dangphan1803/ESP32C3-Google-Map-Navigation-Chronos-Android/docs/images/demo.gif

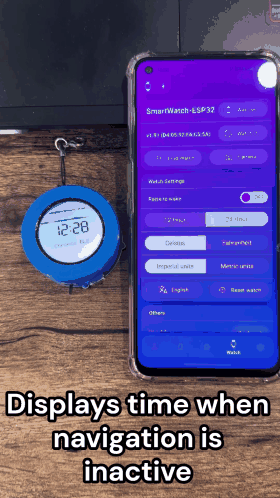
docs/images/demo.gif
