dangphan1803/ESP32C3-Google-Map-Navigation-Chronos-Android/FIle_in_3D/De_VER2.3mf

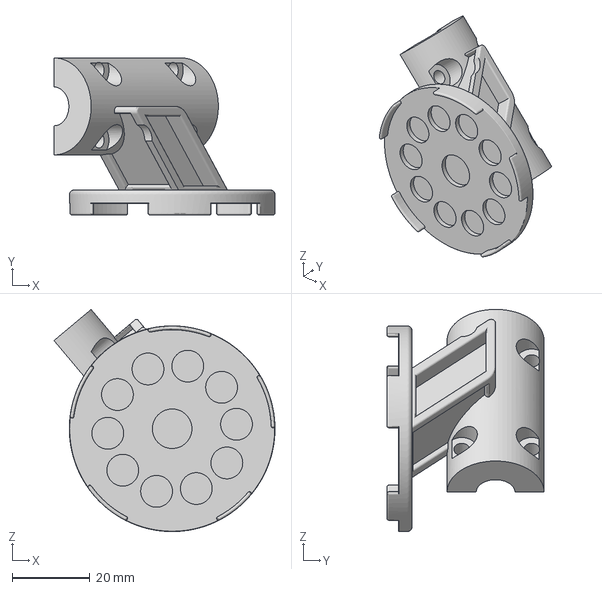
[picture p9: CAD file, 2026-10-22]
FIle_in_3D/De_VER2.3mf
56.9 x 40.5 x 57.2 mm
