dangphan1803/ESP32C3-Google-Map-Navigation-Chronos-Android/FIle_in_3D/Nap_Ver2.3mf

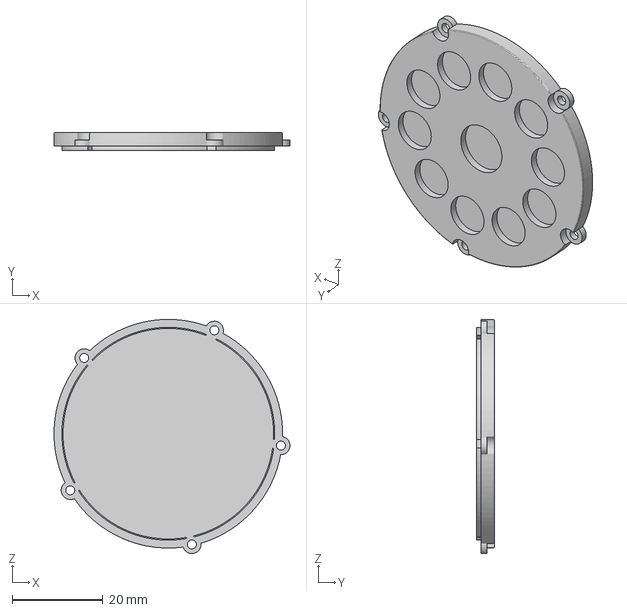
[picture p10: CAD file, 2026-10-22]
FIle_in_3D/Nap_Ver2.3mf
52.1 x 4.00 x 51.7 mm
