dangphan1803/ESP32C3-Google-Map-Navigation-Chronos-Android/FIle_in_3D/Van_Oc.3mf

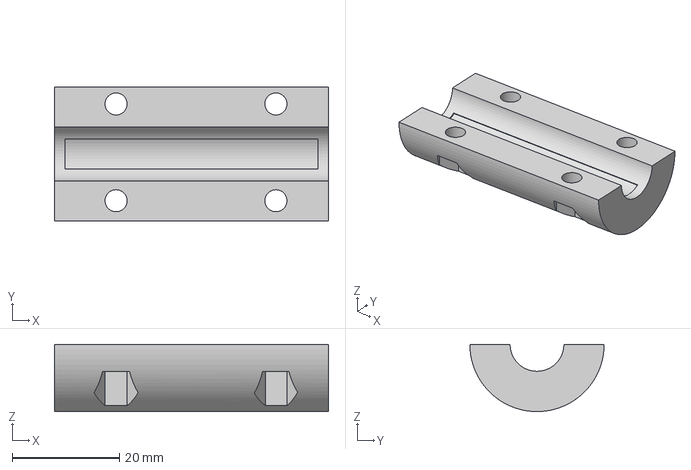
[picture p11: CAD file, 2026-10-22]
FIle_in_3D/Van_Oc.3mf
51.0 x 25.0 x 12.5 mm
