dangphan1803/ESP32C3-Google-Map-Navigation-Chronos-Android/FIle_in_3D/Hop.3mf

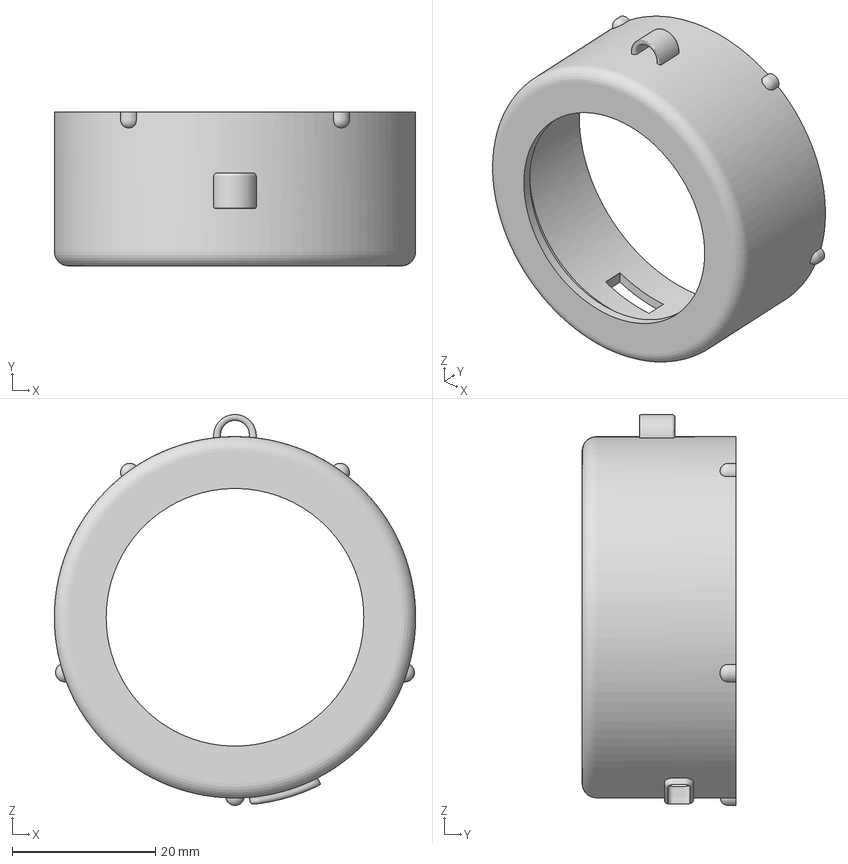
[picture p12: CAD file, 2026-10-22]
FIle_in_3D/Hop.3mf
50.5 x 21.5 x 54.6 mm
