dangphan1803/ESP32C3-Google-Map-Navigation-Chronos-Android/docs/images/CallTest2.jpg

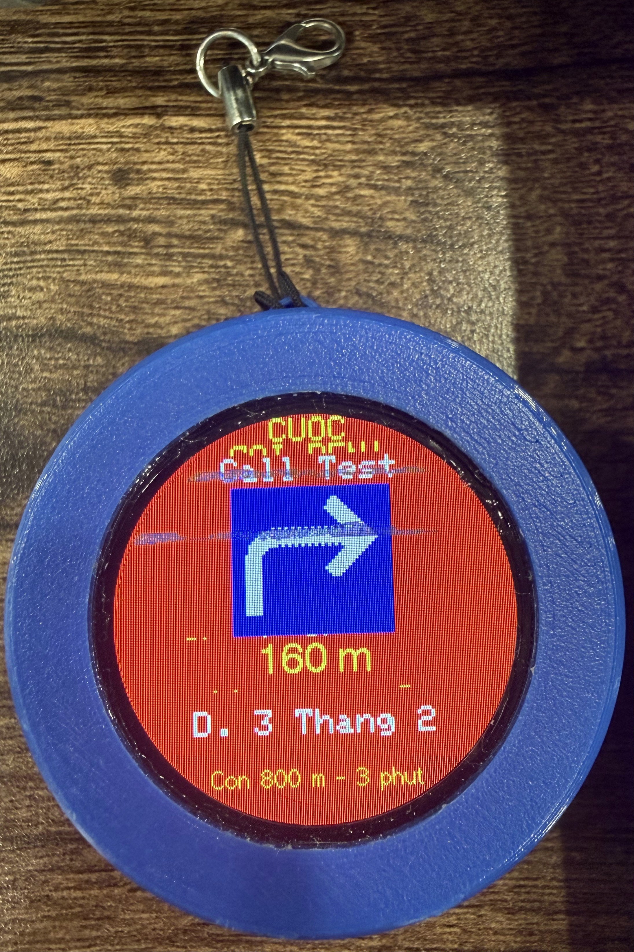
docs/images/CallTest2.jpg
