dangphan1803/ESP32C3-Google-Map-Navigation-Chronos-Android/(commit log)

2026-10-22 docs: update hardware BOM, battery wiring diagram, and flashing instructions
2026-10-23 docs: add real-life demo photos, animated gif, 3D enclosure details, and 20x 8mm magnets in BOM
2026-10-23 fix(media): mute audio track in demo video
