dangphan1803/ESP32C3-Google-Map-Navigation-Chronos-Android/(notices)

Notices in the files:
README.md:
License: MIT
